snasturtle/lego-robot-arm/IMG_5442.jpeg

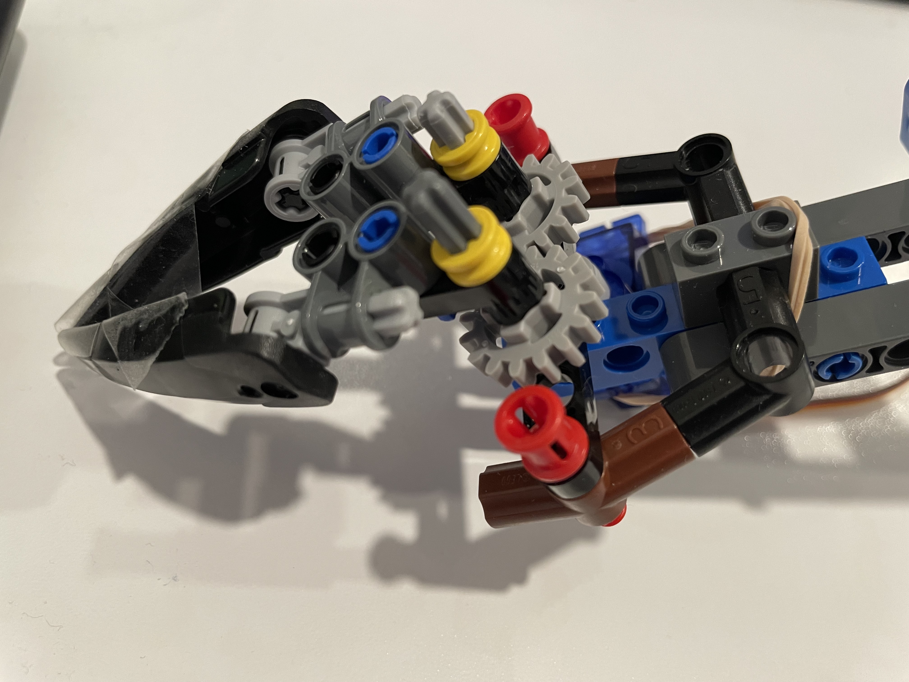
IMG_5442.jpeg
