snasturtle/lego-robot-arm/IMG_5437.jpeg

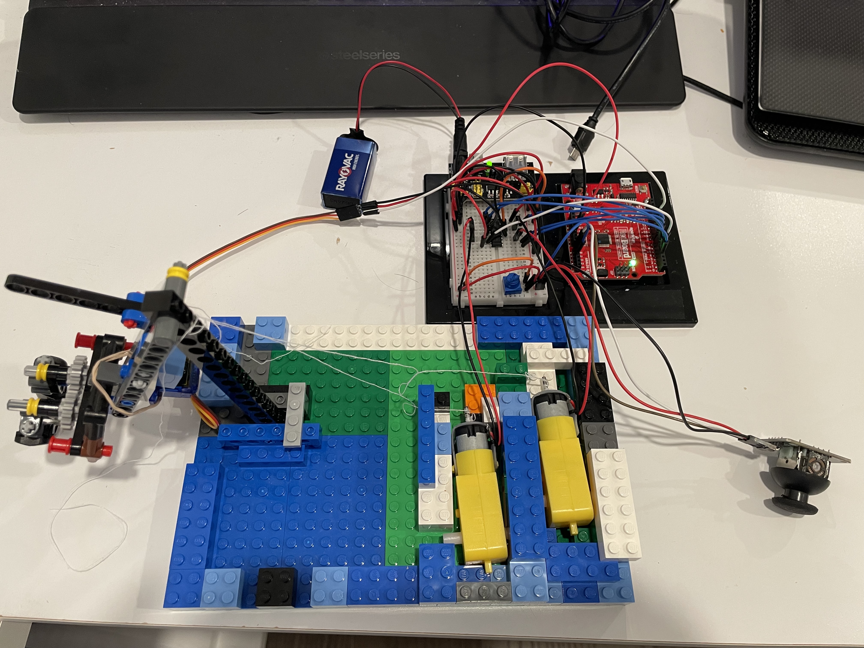
IMG_5437.jpeg
