snasturtle/lego-robot-arm/IMG_5438.jpeg

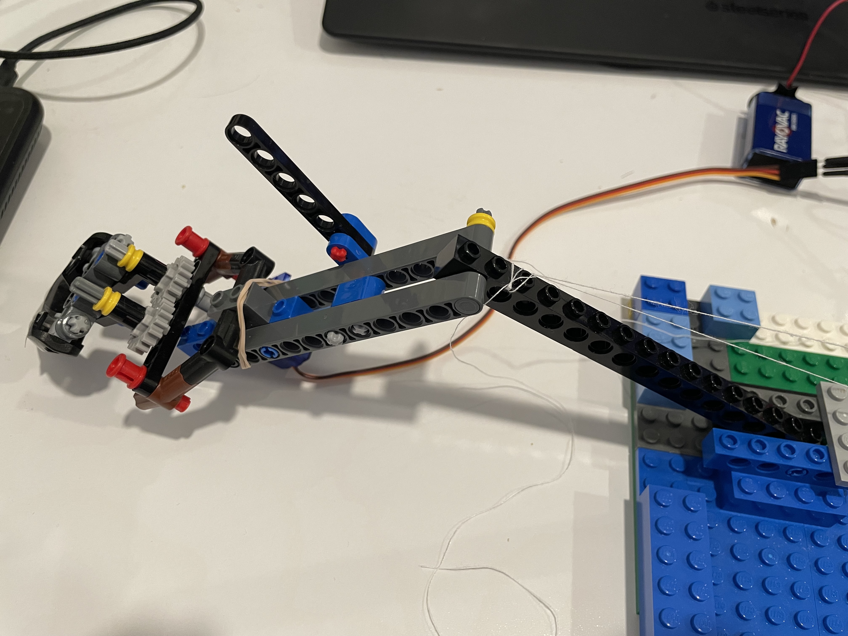
IMG_5438.jpeg
