snasturtle/lego-robot-arm/IMG_5439.jpeg

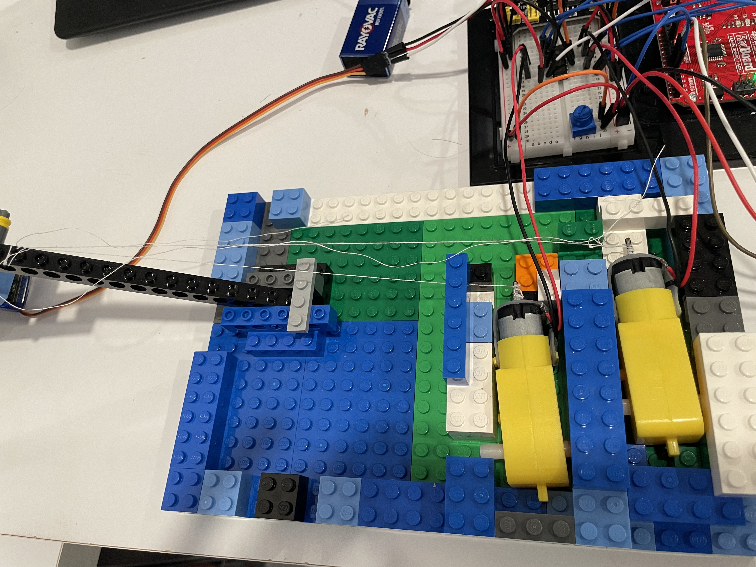
IMG_5439.jpeg
