snasturtle/lego-robot-arm/IMG_5440.jpeg

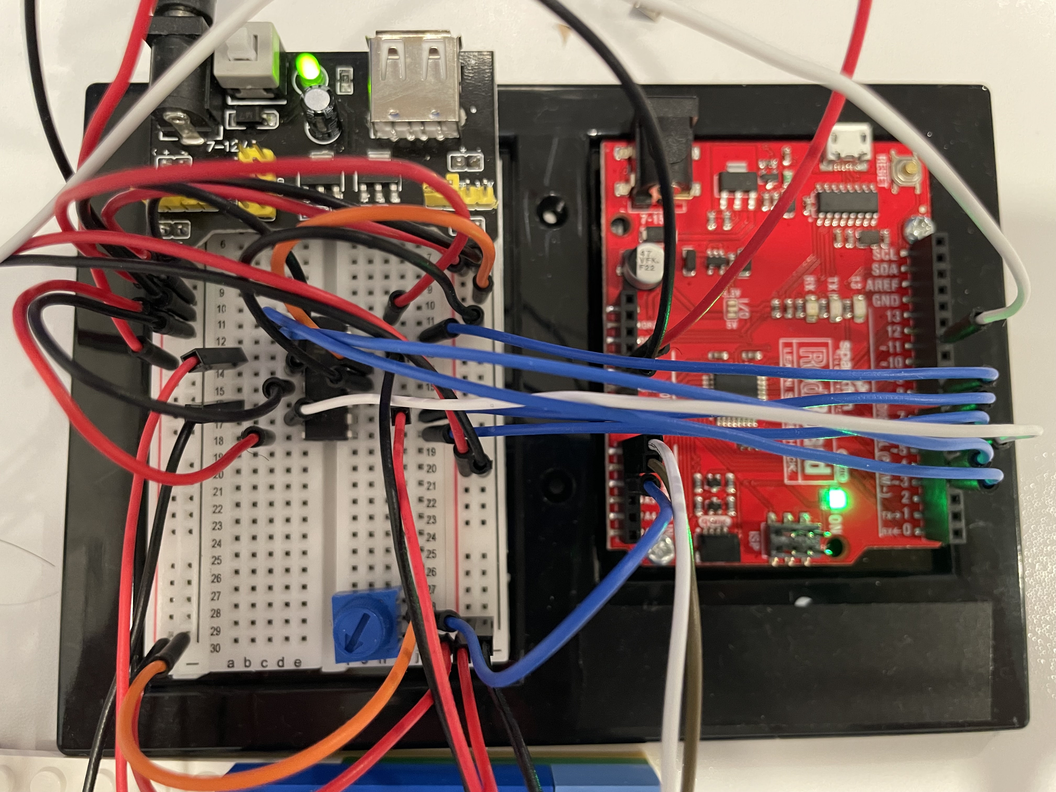
IMG_5440.jpeg
