snasturtle/lego-robot-arm/IMG_5441.jpeg

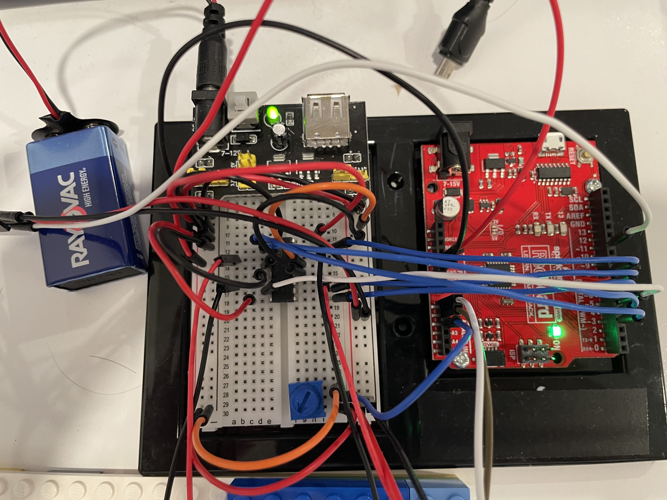
IMG_5441.jpeg
