snasturtle/lego-robot-arm/IMG_5444.jpeg

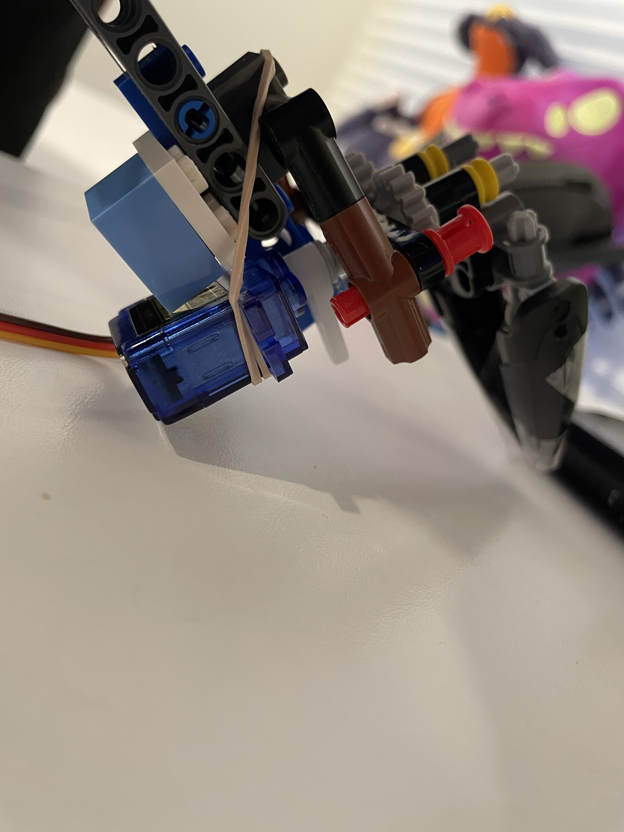
IMG_5444.jpeg
