snasturtle/lego-robot-arm/IMG_5445.jpeg

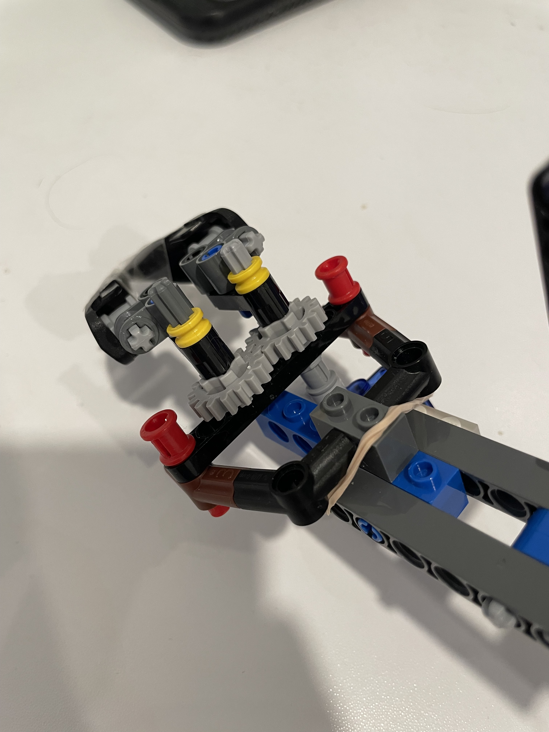
IMG_5445.jpeg
